net-cat/tandy_1000_ps2_keyboard/(commit log)

2020-05-13 Initial checkin of code and README.md
    Needs a *lot* of cleaning up, but it does work except for HOLD, BREAK and PRINT.
2020-06-07 Prevent interrupts when bit-banging keys to the Tandy.
    [tandy_kbd.ino]
2020-06-07 Map PS/2 Scroll Lock to Tandy Hold
    * Also adding a way to disable debug print. (Other than intial startup banner.)
2020-06-26 Adding the support for an XT Compatible Mode
    Right now, it just affects Up, Down, Left, Right, F11 and F12.
    It works for games that read the hardware directly rather than using BIOS routines.
    There isn't currently a way to activate it. (Have to troubleshoot the lock keys, first.)
2020-06-27 Bugfixes!
    * Seems the debug prints got turned back on.
    * noIterrupts() and interrupts() were backwards.
    * Fixed problems with getLock(). (Interrupts related.)
    * Scroll Lock will now enable XT Compatibility Mode
    [tandy_kbd.ino]
2020-07-07 Prevent Arduino from freezing when you press Caps or Num Lock
    * Updated documentation.
    * Updated wiring directions and images.
    * Documented XT Compatibility mode.
    [tandy_kbd.ino]
